yuelai-feng/STRING-retractor/README.md

# 🎣 STRING: Stereotax-Tethered Retractor for Implanting Neurophysiology Gear

STRING is a retractor system designed for stereotaxic cranial implant surgeries in neurophysiology research. It is extremely low-profile, self-retaining, and allows for skin retraction in all directions.

The STRING retractor system consists of:

* a blunt skin hook, which hooks onto the skin margin;
* a thin string (suture) tied to the hook; and
* a 2-piece holder, which clamps onto the stereotax arm (over the surgical drape) and holds the string in place.

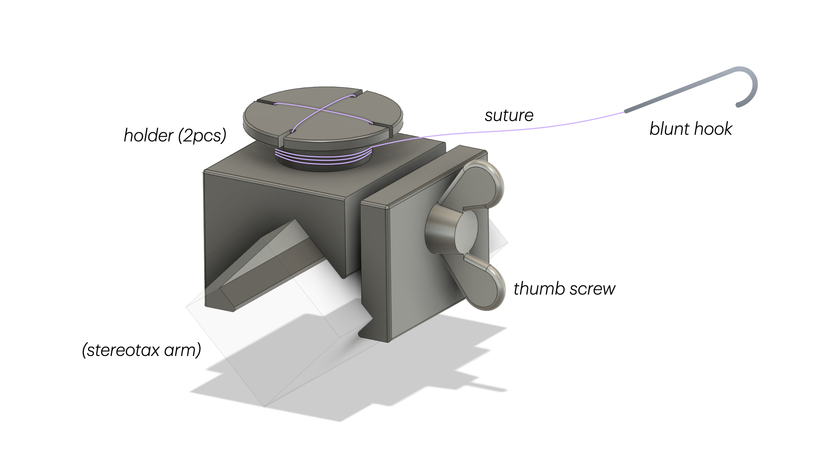
[picture p1: Images/STRING.jpeg]
STRING schematic


## Table of contents
- [About the design](#about-the-design)
- [Building STRING](#building-string)
- [Using STRING](#using-string)
- [Contact](#contact)

## About the design

STRING is inspired by the [Lone Star™ Retractor System](https://www.coopersurgical.com/brand/lone-star/). It applies the same principle but is adapted for stereotaxic cranial implant surgeries. Because the retractor strings are anchored to the stereotax arms, STRING provides sturdy, hands-free retraction while leaving more clearance around the surgical site.

## Building STRING

### 0. Gather tools and supplies

| | **Name** | **Qty** | **Purpose & Specifications** |
| --- | --- | --- | --- |
| **Holders** (4 sets) | Holder P1 | 4 | Custom part; STL and STEP files are in this repository. See 3D printing instructions below. |
| | Holder P2 | 4 | Custom part; STL and STEP files are in this repository. See 3D printing instructions below. |
| | Thumb screw | 4 | Clamps the holder onto the stereotax arm. M5 × ~10 mm. [Example product](https://www.mcmaster.com/92625A309/) |
| **Hooks & Strings** | Fishing hooks | As needed | Blunted to make the skin hooks. Stainless steel, with a gap of ~5-8 mm. [Example product](https://www.amazon.com/dp/B0FR7QF42M) |
| | Suture | As needed | To make the strings. Braided (e.g. silk); size from 3-0 to 2; length ~18 in (longer suture can be cut to length); no needle needed. Material and sterility requirements depend on how you assemble/sterilize the parts — see [2. Assemble and sterilize](#2-assemble-and-sterilize). |
| **Assembly & Sterilization** | M5 tap | 1 | For threading the screw hole in the 3D-printed holder. |
| | Dremel with diamond cutting wheel | 1 | For blunting the fishing hooks. |
| | Sterilization supplies & equipment | As needed | For sterilizing the parts for surgery use (e.g. sterilization pouches, gas sterilizer, autoclave). See [2. Assemble and sterilize](#2-assemble-and-sterilize) for details. |

> [!TIP]
> **3D Printing Instructions:**
> - **Material:** Use a tough material (e.g. Formlabs Tough 2000) so the holder doesn't snap under tension.
> - **Resolution:** High resolution isn't necessary; 0.05 mm works well.
> - **Supports:** Avoid putting too much support on the circular part of the holder. The small slits may not print cleanly otherwise.

### 1. Prepare the holders and hooks

- Thread the hole in holder P1 using the M5 tap. The M5 thumb screws should be able to screw in nicely.
- Using the Dremel, grind off the sharp tip and barb on the fishing hooks and smooth the tip. The photo below shows a blunt hook (left) and the original fishing hook (right). Make as many hooks as you may need.

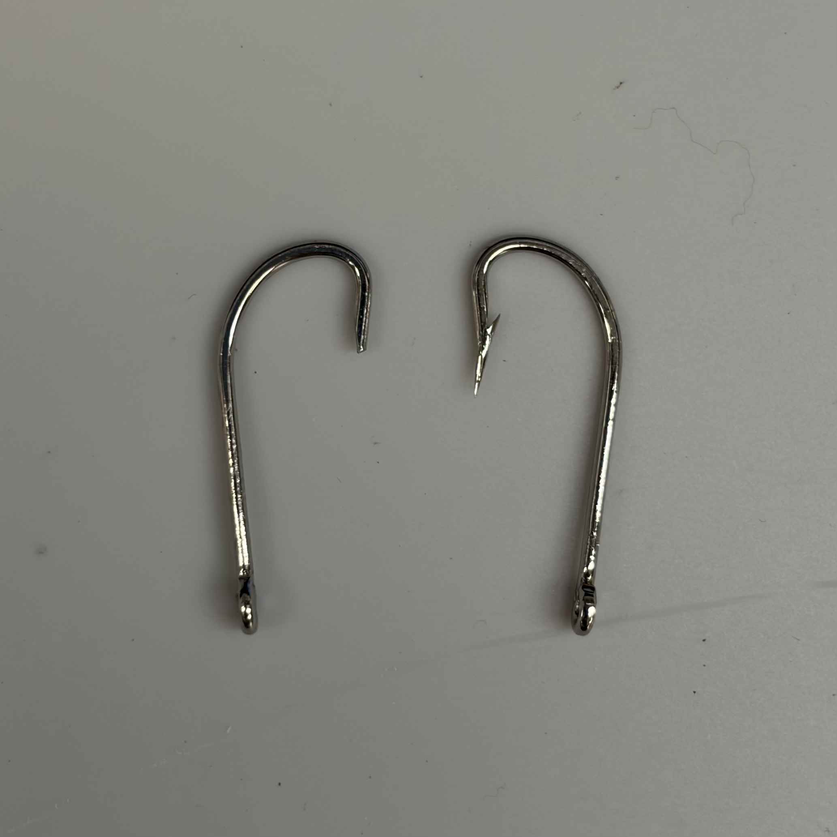
[picture p2: Images/blunt_hook.jpeg]
Blunted (left) vs. sharp (right) fishing hook
  

### 2. Assemble and sterilize

> [!CAUTION]
> Follow your institution's SOPs and consult your veterinary staff on which method is the most appropriate.

#### Option 1: Assemble *before* surgery *(recommended)*

For this method, you do not need sterile suture, but **make sure the suture material is compatible with your sterilization method**.

- Gas-sterilize the holders (P1, P2, and thumb screws). Pack the parts loosely assembled in the sterilization pouch so the gas can reach all surfaces. Note that most resins cannot be autoclaved.
- Prepare the hooks and suture:
  1. Wearing clean gloves, cut the suture to the desired length if needed.
  2. Tie one hook to each strand with a secure knot (e.g. an [improved clinch knot](https://www.animatedknots.com/improved-clinch-knot)).
  3. Place the assembled hooks in a sterilization pouch, and gas-sterilize. You may autoclave instead if your suture and hook materials are compatible.

#### Option 2: Assemble *during* surgery

This method takes up more time during the surgery compared to Option 1. For this method, **you must use sterile suture**.

- Gas-sterilize the holders (P1, P2, and thumb screws). Pack the parts loosely assembled in the sterilization pouch so the gas can reach all surfaces. Note that most resins cannot be autoclaved.
- Gas-sterilize or autoclave the blunt hooks.
- Get sterile suture.
- During surgery, the scrubbed surgeon assembles the hooks and suture: cut the suture to the desired length if needed, then tie one hook to each strand with a secure knot (e.g. an [improved clinch knot](https://www.animatedknots.com/improved-clinch-knot)).

## Using STRING

> This section assumes that everything has been appropriately sterilized for the surgery. For how to sterilize STRING, see [2. Assemble and sterilize](#2-assemble-and-sterilize).

1. Unpack all the retractor components (holders, hooks, and string) using aseptic technique.
2. Clamp the holders onto the stereotax arm, above the surgical drape.
3. Hook the skin margin, wrap the string around the holder's circular cleat a few times, then secure the string in one of the cleat's slits. A few wraps are usually enough to hold the string in place; if it slips, add more.
4. Adjust each string to apply only as much tension as needed for adequate exposure. To loosen or tighten, release the string from the slit, unwrap as needed, and re-secure it.

> [!CAUTION]
> Prolonged or excessive retraction can compromise blood flow to the skin margins. Only retract as long as necessary. Periodically check the skin margins and relax the strings as needed, following your institution's SOPs and your veterinary staff's guidance.

See demo photo below:

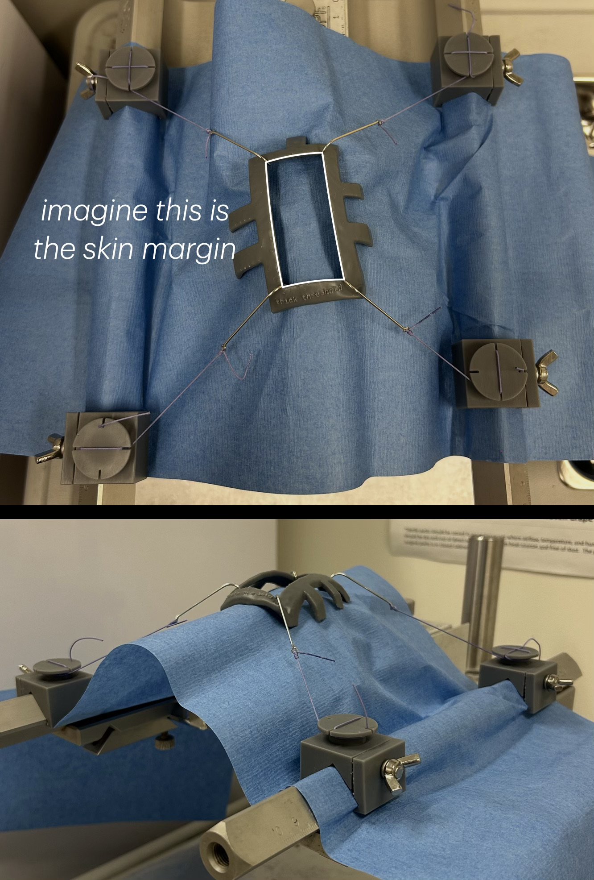
[picture p3: Images/STRING_demo.jpeg]
STRING demo


## Future Directions

- **CNC-friendly holder design:** Adapt the holder CAD models for CNC machining so the holders can be made from metal (e.g. stainless steel or aluminum). Metal holders would be sturdier, more durable for long-term use, and autoclavable.

## Contact

For inquiries and suggestions, feel free to contact Yuelai Feng at yuelai.f@outlook.com.
