yuelai-feng/STRING-retractor/CAD Files/STRING_holder_p1.stl

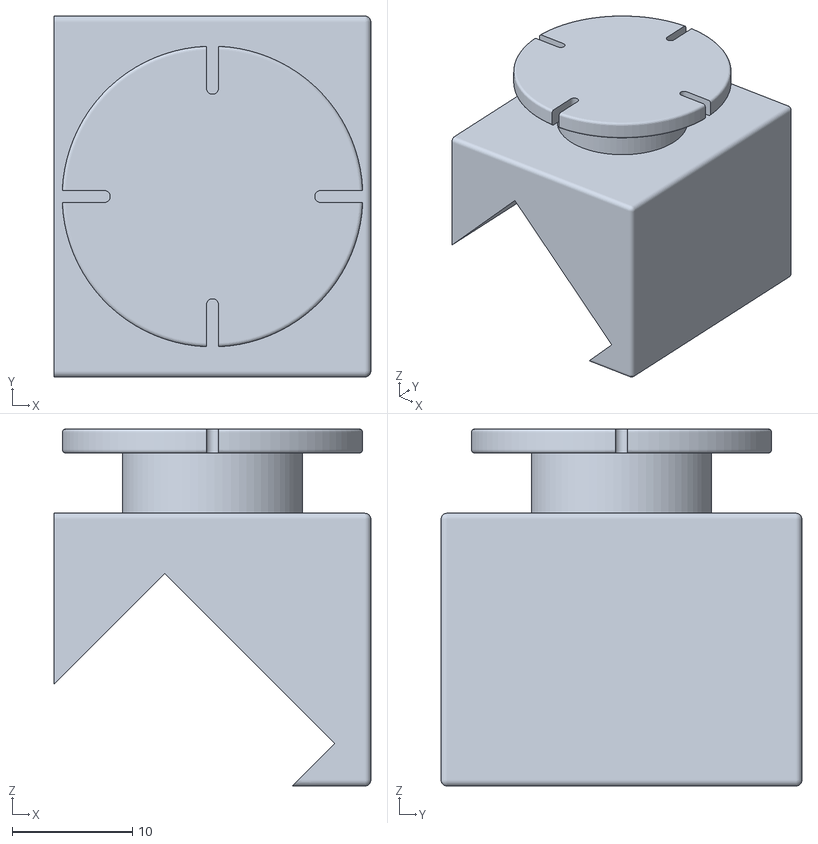
[picture p4: CAD file, 2026-10-22]
CAD Files/STRING_holder_p1.stl
26.3 x 30.0 x 29.7
