yuelai-feng/STRING-retractor/CAD Files/STRING_holder.step

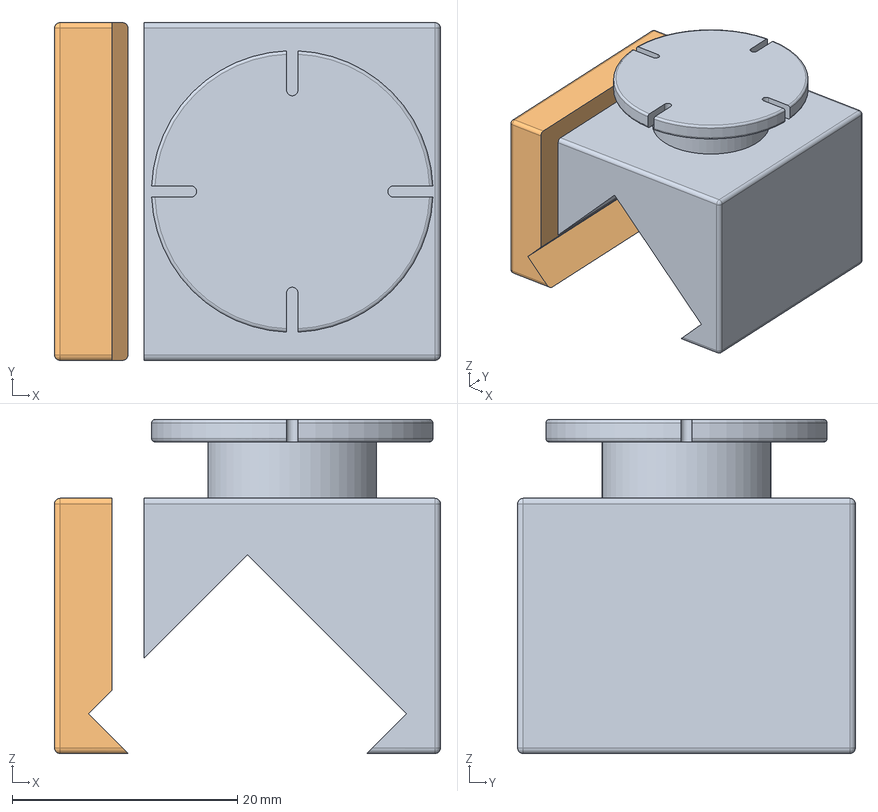
[picture p5: CAD file, 2026-10-22]
CAD Files/STRING_holder.step
34.3 x 30.0 x 29.7 mm
