yuelai-feng/STRING-retractor/CAD Files/STRING_holder_p2.stl

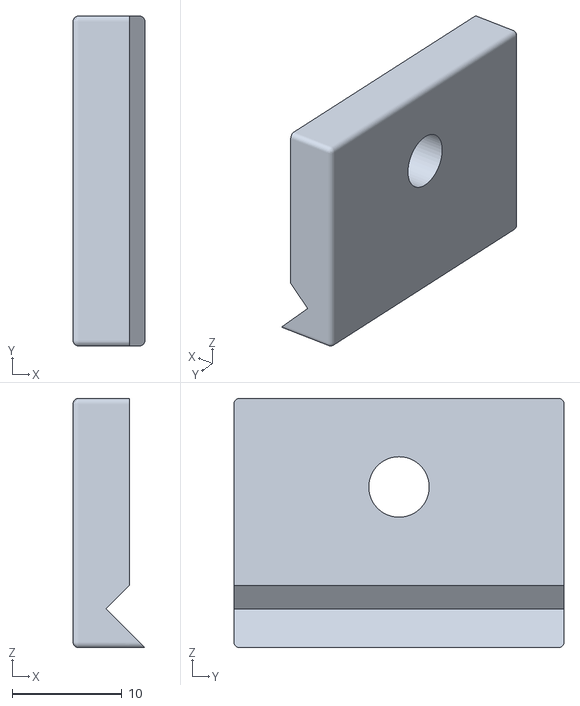
[picture p6: CAD file, 2026-10-22]
CAD Files/STRING_holder_p2.stl
6.54 x 30.0 x 22.7
